resset/himudev_hw/README.md

# hIMUdev

hIMUdev is a RISC-V powered IMU evaluation board. Current version (1.0) hasn't been tested yet, so expect updates and changes.

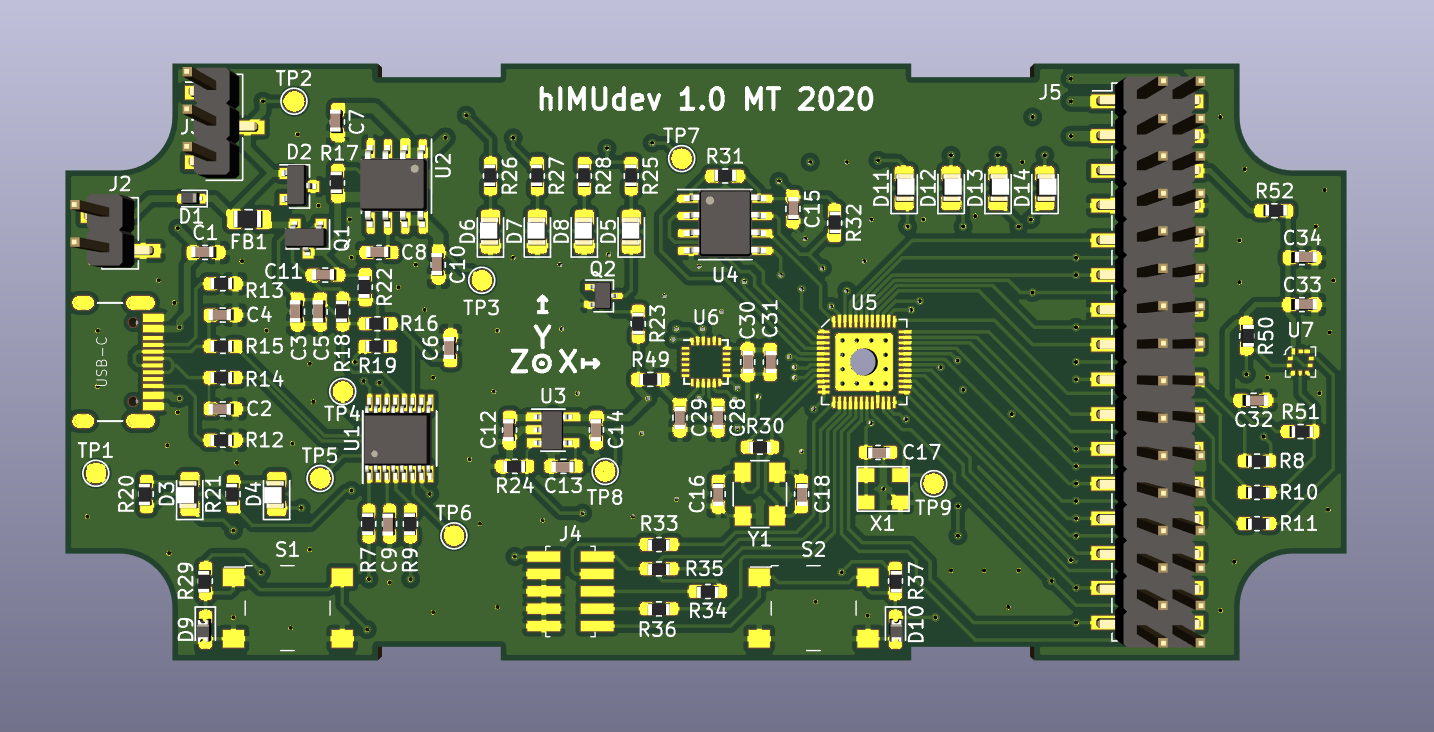
[picture p1: img/3d_viewer_board.png]
3D view

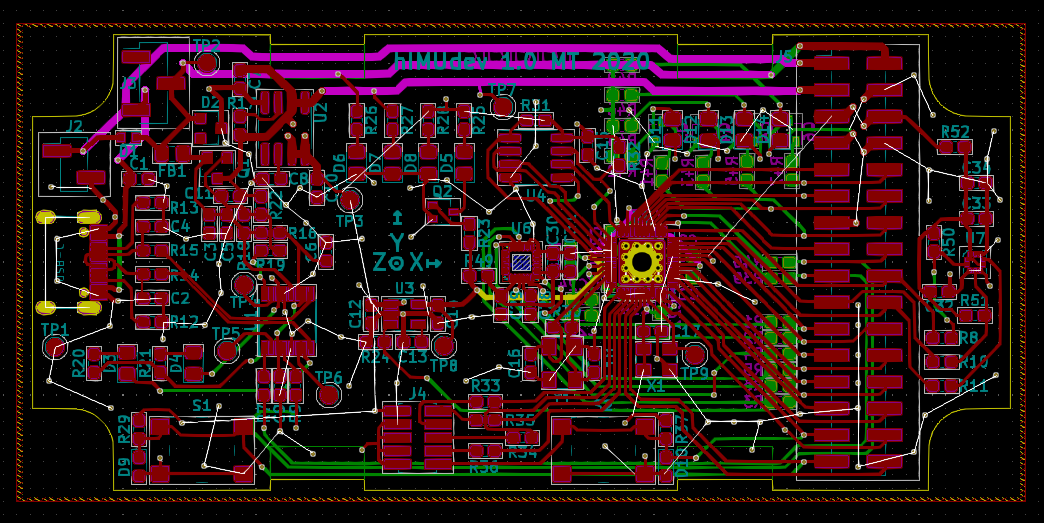
[picture p2: img/pcbnew_traces.png]
Layout view
