resset/himudev_hw/himudev.kicad_pcb

## KiCad design himudev.kicad_pcb (2020-05-10)

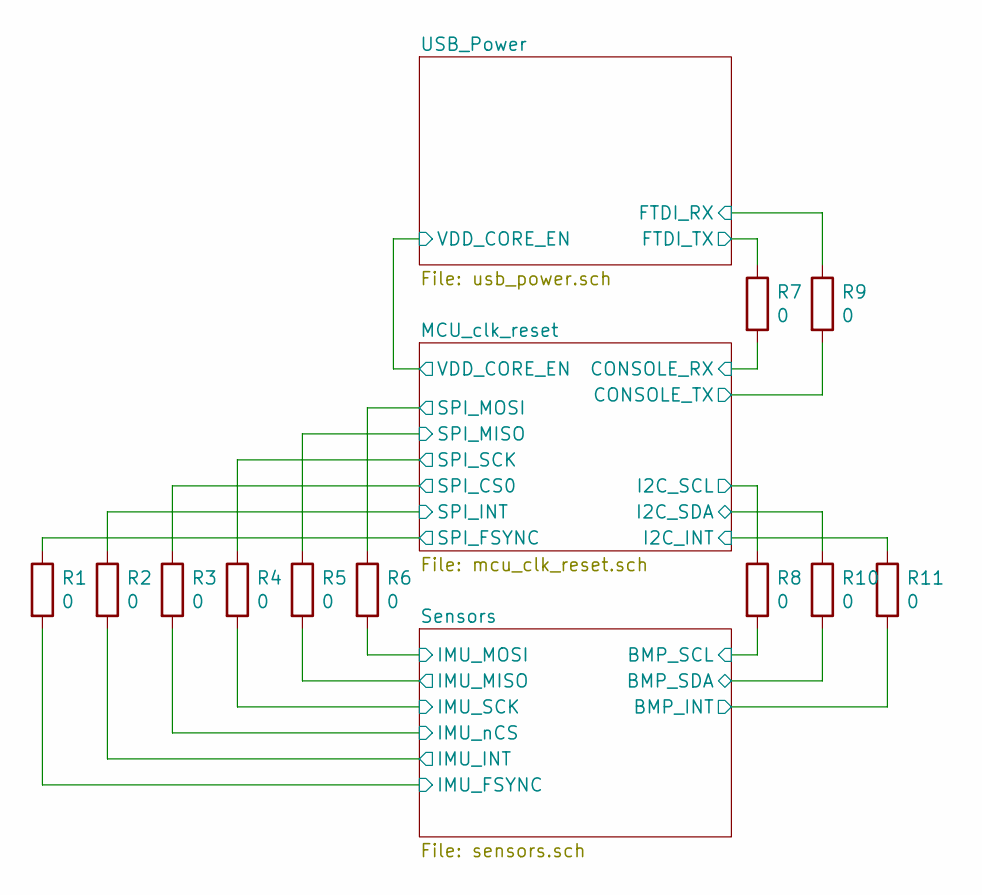
[picture p3: schematic himudev.sch]

Parts:
R1, R2, R3, R4, R5, R6, R7, R8, R9, R10, R11: 0; R_0603_1608Metric_Pad1.05x0.95mm_HandSolder

Connections:
/MCU_clk_reset/CONSOLE_RX: R7.2; also elsewhere on the board
/MCU_clk_reset/CONSOLE_TX: R9.2; also elsewhere on the board
/MCU_clk_reset/I2C_INT: R11.1; also elsewhere on the board
/MCU_clk_reset/I2C_SCL: R8.1; also elsewhere on the board
/MCU_clk_reset/I2C_SDA: R10.1; also elsewhere on the board
/MCU_clk_reset/SPI_CS0: R3.1; also elsewhere on the board
/MCU_clk_reset/SPI_FSYNC: R1.1; also elsewhere on the board
/MCU_clk_reset/SPI_INT: R2.1; also elsewhere on the board
/MCU_clk_reset/SPI_MISO: R5.1; also elsewhere on the board
/MCU_clk_reset/SPI_MOSI: R6.1; also elsewhere on the board
/MCU_clk_reset/SPI_SCK: R4.1; also elsewhere on the board
/Sensors/BMP_INT: R11.2; also elsewhere on the board
/Sensors/BMP_SCL: R8.2; also elsewhere on the board
/Sensors/BMP_SDA: R10.2; also elsewhere on the board
/Sensors/IMU_FSYNC: R1.2; also elsewhere on the board
/Sensors/IMU_INT: R2.2; also elsewhere on the board
/Sensors/IMU_MISO: R5.2; also elsewhere on the board
/Sensors/IMU_MOSI: R6.2; also elsewhere on the board
/Sensors/IMU_SCK: R4.2; also elsewhere on the board
/Sensors/IMU_nCS: R3.2; also elsewhere on the board
/USB_Power/FTDI_RX: R9.1; also elsewhere on the board
/USB_Power/FTDI_TX: R7.1; also elsewhere on the board

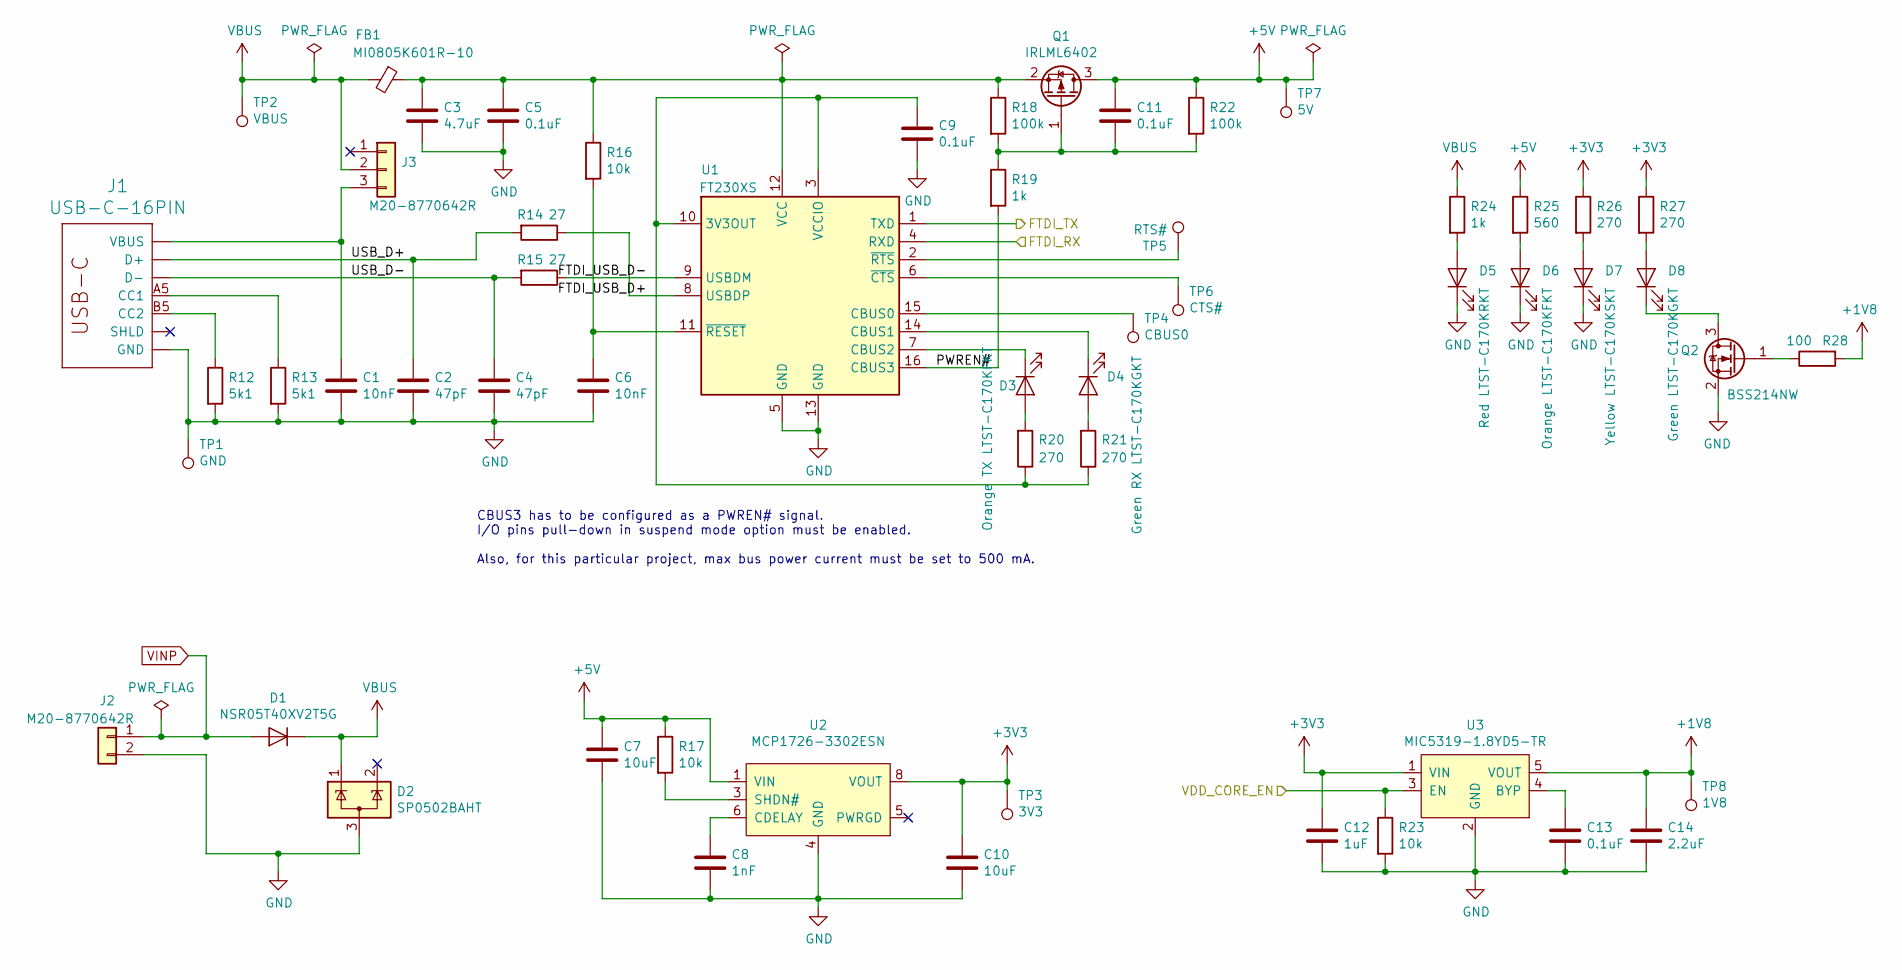
[picture p4: schematic usb_power.sch]

Parts:
C1, C6: 10nF; C_0603_1608Metric_Pad1.05x0.95mm_HandSolder
C2, C4: 47pF; C_0603_1608Metric_Pad1.05x0.95mm_HandSolder
C3: 4.7uF; C_0603_1608Metric_Pad1.05x0.95mm_HandSolder
C5, C9, C11, C13: 0.1uF; C_0603_1608Metric_Pad1.05x0.95mm_HandSolder
C7, C10: 10uF; C_0603_1608Metric_Pad1.05x0.95mm_HandSolder
C8: 1nF; C_0603_1608Metric_Pad1.05x0.95mm_HandSolder
C12: 1uF; C_0603_1608Metric_Pad1.05x0.95mm_HandSolder
C14: 2.2uF; C_0603_1608Metric_Pad1.05x0.95mm_HandSolder
D1: NSR05T40XV2T5G; D_SOD-523
D2: SP0502BAHT; SOT-23
D3: Orange TX LTST-C170KFKT; LED_0805_2012Metric_Pad1.15x1.40mm_HandSolder
D4: Green RX LTST-C170KGKT; LED_0805_2012Metric_Pad1.15x1.40mm_HandSolder
D5: Red LTST-C170KRKT; LED_0805_2012Metric_Pad1.15x1.40mm_HandSolder
D6: Orange LTST-C170KFKT; LED_0805_2012Metric_Pad1.15x1.40mm_HandSolder
D7: Yellow LTST-C170KSKT; LED_0805_2012Metric_Pad1.15x1.40mm_HandSolder
D8: Green LTST-C170KGKT; LED_0805_2012Metric_Pad1.15x1.40mm_HandSolder
FB1: MI0805K601R-10; R_0805_2012Metric_Pad1.15x1.40mm_HandSolder
J1: USB-C-16PIN; USB-C-COM-15111
J2: M20-8770642R; PinHeader_1x02_P2.54mm_Vertical_SMD_Pin1Left
J3: M20-8770642R; PinHeader_1x03_P2.54mm_Vertical_SMD_Pin1Left
Q1: IRLML6402; SOT-23
Q2: BSS214NW; SOT-323_SC-70
R12, R13: 5k1; R_0603_1608Metric_Pad1.05x0.95mm_HandSolder
R14, R15: 27; R_0603_1608Metric_Pad1.05x0.95mm_HandSolder
R16, R17, R23: 10k; R_0603_1608Metric_Pad1.05x0.95mm_HandSolder
R18, R22: 100k; R_0603_1608Metric_Pad1.05x0.95mm_HandSolder
R19, R24: 1k; R_0603_1608Metric_Pad1.05x0.95mm_HandSolder
R20, R21, R26, R27: 270; R_0603_1608Metric_Pad1.05x0.95mm_HandSolder
R25: 560; R_0603_1608Metric_Pad1.05x0.95mm_HandSolder
R28: 100; R_0603_1608Metric_Pad1.05x0.95mm_HandSolder
TP1: GND; TestPoint_Pad_D1.5mm
TP2: VBUS; TestPoint_Pad_D1.5mm
TP3: 3V3; TestPoint_Pad_D1.5mm
TP4: CBUS0; TestPoint_Pad_D1.5mm
TP5: RTS#; TestPoint_Pad_D1.5mm
TP6: CTS#; TestPoint_Pad_D1.5mm
TP7: 5V; TestPoint_Pad_D1.5mm
TP8: 1V8; TestPoint_Pad_D1.5mm
U1: FT230XS; SSOP-16_3.9x4.9mm_P0.635mm
U2: MCP1726-3302ESN; SOIC-8_3.9x4.9mm_P1.27mm
U3: MIC5319-1.8YD5-TR; TSOT-23-5

Connections:
+1V8: C14.1, R28.2, TP8.1, U3.5 (VOUT); also elsewhere on the board
+3V3: C10.1, C12.1, R26.1, R27.1, TP3.1, U2.7 (VOUT), U2.8 (VOUT), U3.1 (VIN); also elsewhere on the board
+5V: C7.1, C11.1, Q1.3 (D), R17.1, R22.1, R25.1, TP7.1, U2.1 (VIN), U2.2 (VIN); also elsewhere on the board
/MCU_clk_reset/VDD_CORE_EN: R23.1, U3.3 (EN); also elsewhere on the board
/USB_Power/FTDI_RX: U1.4 (RXD); also elsewhere on the board
/USB_Power/FTDI_TX: U1.1 (TXD); also elsewhere on the board
/USB_Power/FTDI_USB_D+: R14.1, U1.8 (USBDP)
/USB_Power/FTDI_USB_D-: R15.1, U1.9 (USBDM)
/USB_Power/PWREN#: R19.2, U1.16 (CBUS3)
/USB_Power/USB_D+: C2.1, J1.A6 (D+), J1.B6 (D+), R14.2
/USB_Power/USB_D-: C4.1, J1.A7 (D-), J1.B7 (D-), R15.2
GND: C1.2, C2.2, C3.2, C4.2, C5.2, C6.2, C7.2, C8.2, C9.2, C10.2, C12.2, C13.2, C14.2, D2.3 (A), D5.1 (K), D6.1 (K), D7.1 (K), J1.GND, J1.GND2 (GND), J2.2, Q2.2 (S), R12.2, R13.2, R23.2, TP1.1, U1.5 (GND), U1.13 (GND), U2.4 (GND), U3.2 (GND); also elsewhere on the board
unnamed: C1.1, J1.VBUS1 (VBUS), J1.VBUS2 (VBUS), J3.3
unnamed: C3.1, C5.1, FB1.1, Q1.2 (S), R16.1, R18.1, U1.12 (VCC)
unnamed: C6.1, R16.2, U1.11 (~RESET)
unnamed: C8.1, U2.6 (CDELAY)
unnamed: C9.1, R20.1, R21.1, U1.3 (VCCIO), U1.10 (3V3OUT)
unnamed: C11.2, Q1.1 (G), R18.2, R19.1, R22.2
unnamed: C13.1, U3.4 (BYP)
unnamed: D3.1 (K), U1.7 (CBUS2)
unnamed: D3.2 (A), R20.2
unnamed: D4.1 (K), U1.14 (CBUS1)
unnamed: D4.2 (A), R21.2
unnamed: D5.2 (A), R24.2
unnamed: D6.2 (A), R25.2
unnamed: D7.2 (A), R26.2
unnamed: D8.1 (K), Q2.3 (D)
unnamed: D8.2 (A), R27.2
unnamed: J1.A5 (CC1), R13.1
unnamed: J1.B5 (CC2), R12.1
unnamed: J1.SHLD1 (SHLD), J1.SHLD2 (SHLD), J1.SHLD3 (SHLD), J1.SHLD4 (SHLD), J1.SHLD5 (SHLD), J1.SHLD6 (SHLD), J1.SHLD7 (SHLD), J1.SHLD8 (SHLD)
unnamed: Q2.1 (G), R28.1
unnamed: R17.2, U2.3 (SHDN#)
unnamed: TP4.1, U1.15 (CBUS0)
unnamed: TP5.1, U1.2 (~RTS)
unnamed: TP6.1, U1.6 (~CTS)
VBUS: D1.1 (K), D2.1 (K), FB1.2, J3.2, R24.1, TP2.1; also elsewhere on the board
VINP: D1.2 (A), J2.1; also elsewhere on the board

Notes on the sheet:
CBUS3 has to be configured as a PWREN# signal. I/O pins pull-down in suspend mode option must be enabled. Also, for this particular project, max bus power current must be set to 500 mA.

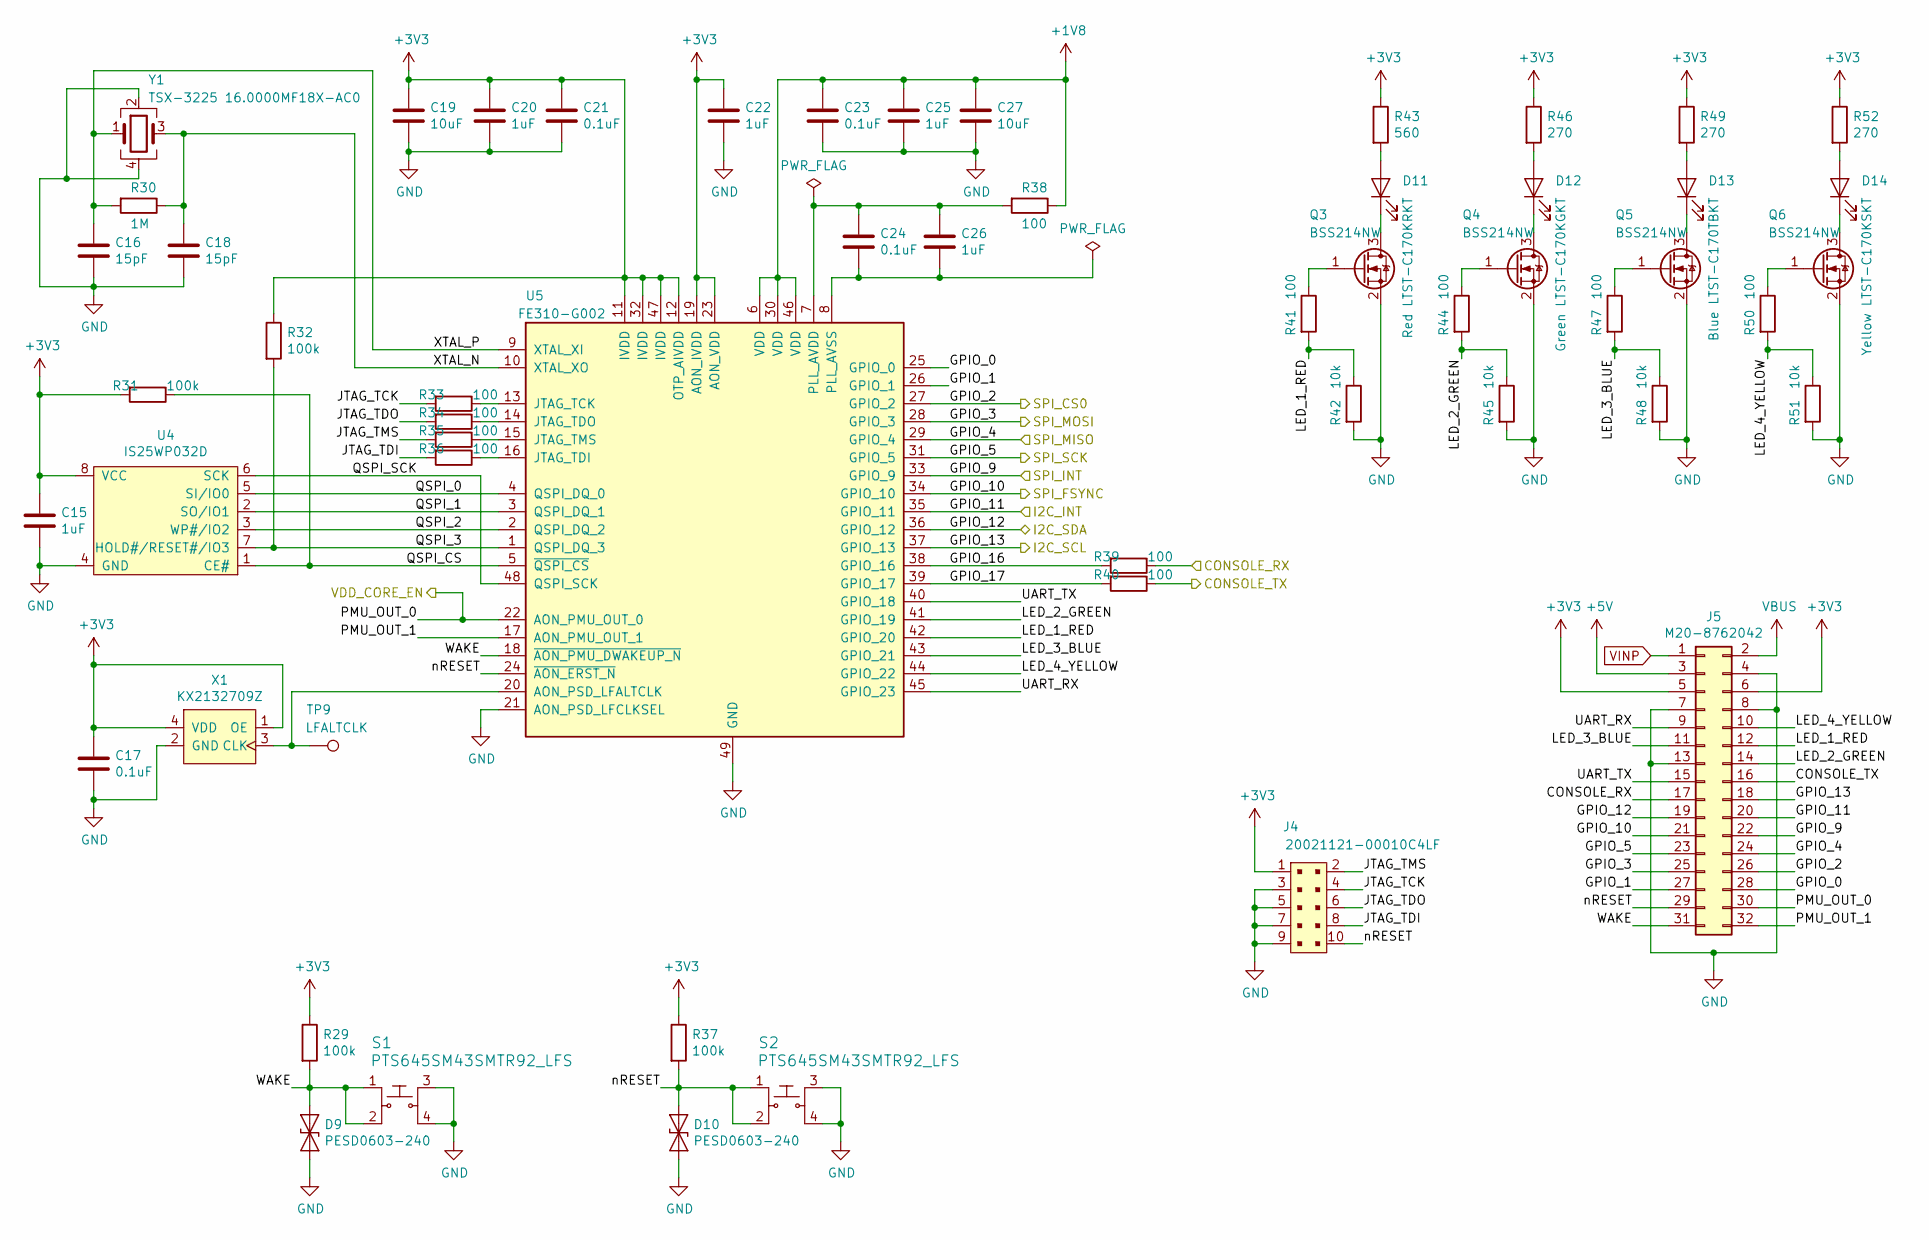
[picture p5: schematic mcu_clk_reset.sch]

Parts:
C15, C20, C22, C25, C26: 1uF; C_0603_1608Metric_Pad1.05x0.95mm_HandSolder
C16, C18: 15pF; C_0603_1608Metric_Pad1.05x0.95mm_HandSolder
C17, C21, C23, C24: 0.1uF; C_0603_1608Metric_Pad1.05x0.95mm_HandSolder
C19, C27: 10uF; C_0603_1608Metric_Pad1.05x0.95mm_HandSolder
D9, D10: PESD0603-240; D_0603_1608Metric_Pad1.05x0.95mm_HandSolder
D11: Red LTST-C170KRKT; LED_0805_2012Metric_Pad1.15x1.40mm_HandSolder
D12: Green LTST-C170KGKT; LED_0805_2012Metric_Pad1.15x1.40mm_HandSolder
D13: Blue LTST-C170TBKT; LED_0805_2012Metric_Pad1.15x1.40mm_HandSolder
D14: Yellow LTST-C170KSKT; LED_0805_2012Metric_Pad1.15x1.40mm_HandSolder
J4: 20021121-00010C4LF; PinHeader_2x5_P1.27mm; MPN 20021121-00010C4LF; Digi-Key_PN 609-3695-1-ND
J5: M20-8762042; PinHeader_2x16_P2.54mm_Vertical_SMD
Q3, Q4, Q5, Q6: BSS214NW; SOT-323_SC-70
R29, R31, R32, R37: 100k; R_0603_1608Metric_Pad1.05x0.95mm_HandSolder
R30: 1M; R_0603_1608Metric_Pad1.05x0.95mm_HandSolder
R33, R34, R35, R36, R38, R39, R40, R41, R44, R47, R50: 100; R_0603_1608Metric_Pad1.05x0.95mm_HandSolder
R42, R45, R48, R51: 10k; R_0603_1608Metric_Pad1.05x0.95mm_HandSolder
R43: 560; R_0603_1608Metric_Pad1.05x0.95mm_HandSolder
R46, R49, R52: 270; R_0603_1608Metric_Pad1.05x0.95mm_HandSolder
S1, S2: PTS645SM43SMTR92_LFS; Switch_Tactile_SMD_6x6mm_PTS645; MPN PTS645SM43SMTR92 LFS; Digi-Key_PN CKN9112CT-ND
TP9: LFALTCLK; TestPoint_Pad_D1.5mm
U4: IS25WP032D; SOIC-8_3.9x4.9mm_P1.27mm
U5: FE310-G002; QFN-48-1EP_6x6mm_P0.4mm_EP4.2x4.2mm_BigVia
X1: KX2132709Z
Y1: TSX-3225 16.0000MF18X-AC0; TSX-3225

Connections:
+1V8: C23.1, C25.1, C27.1, R38.1, U5.6 (VDD), U5.30 (VDD), U5.46 (VDD); also elsewhere on the board
+3V3: C15.1, C17.1, C19.1, C20.1, C21.1, C22.1, J4.1, J5.5, J5.6, R29.1, R31.2, R32.1, R37.1, R43.1, R46.1, R49.1, R52.1, U4.8 (VCC), U5.11 (IVDD), U5.12 (OTP_AIVDD), U5.19 (AON_IVDD), U5.23 (AON_VDD), U5.32 (IVDD), U5.47 (IVDD), X1.1 (OE), X1.4 (VDD); also elsewhere on the board
+5V: J5.3; also elsewhere on the board
/MCU_clk_reset/CONSOLE_RX: J5.17, R39.1; also elsewhere on the board
/MCU_clk_reset/CONSOLE_TX: J5.16, R40.1; also elsewhere on the board
/MCU_clk_reset/GPIO_0: J5.28, U5.25 (GPIO_0)
/MCU_clk_reset/GPIO_1: J5.27, U5.26 (GPIO_1)
/MCU_clk_reset/GPIO_16: R39.2, U5.38 (GPIO_16)
/MCU_clk_reset/GPIO_17: R40.2, U5.39 (GPIO_17)
/MCU_clk_reset/I2C_INT: J5.20, U5.35 (GPIO_11); also elsewhere on the board
/MCU_clk_reset/I2C_SCL: J5.18, U5.37 (GPIO_13); also elsewhere on the board
/MCU_clk_reset/I2C_SDA: J5.19, U5.36 (GPIO_12); also elsewhere on the board
/MCU_clk_reset/JTAG_TCK: J4.4, R33.2
/MCU_clk_reset/JTAG_TDI: J4.8, R36.2
/MCU_clk_reset/JTAG_TDO: J4.6, R34.2
/MCU_clk_reset/JTAG_TMS: J4.2, R35.2
/MCU_clk_reset/LED_1_RED: J5.12, R41.2, R42.1, U5.42 (GPIO_20)
/MCU_clk_reset/LED_2_GREEN: J5.14, R44.2, R45.1, U5.41 (GPIO_19)
/MCU_clk_reset/LED_3_BLUE: J5.11, R47.2, R48.1, U5.43 (GPIO_21)
/MCU_clk_reset/LED_4_YELLOW: J5.10, R50.2, R51.1, U5.44 (GPIO_22)
/MCU_clk_reset/PMU_OUT_1: J5.32, U5.17 (AON_PMU_OUT_1)
/MCU_clk_reset/QSPI_0: U4.5 (SI/IO0), U5.4 (QSPI_DQ_0)
/MCU_clk_reset/QSPI_1: U4.2 (SO/IO1), U5.3 (QSPI_DQ_1)
/MCU_clk_reset/QSPI_2: U4.3 (WP#/IO2), U5.2 (QSPI_DQ_2)
/MCU_clk_reset/QSPI_3: R32.2, U4.7 (HOLD#/RESET#/IO3), U5.1 (QSPI_DQ_3)
/MCU_clk_reset/QSPI_CS: R31.1, U4.1 (CE#), U5.5 (~QSPI_CS)
/MCU_clk_reset/QSPI_SCK: U4.6 (SCK), U5.48 (QSPI_SCK)
/MCU_clk_reset/SPI_CS0: J5.26, U5.27 (GPIO_2); also elsewhere on the board
/MCU_clk_reset/SPI_FSYNC: J5.21, U5.34 (GPIO_10); also elsewhere on the board
/MCU_clk_reset/SPI_INT: J5.22, U5.33 (GPIO_9); also elsewhere on the board
/MCU_clk_reset/SPI_MISO: J5.24, U5.29 (GPIO_4); also elsewhere on the board
/MCU_clk_reset/SPI_MOSI: J5.25, U5.28 (GPIO_3); also elsewhere on the board
/MCU_clk_reset/SPI_SCK: J5.23, U5.31 (GPIO_5); also elsewhere on the board
/MCU_clk_reset/UART_RX: J5.9, U5.45 (GPIO_23)
/MCU_clk_reset/UART_TX: J5.15, U5.40 (GPIO_18)
/MCU_clk_reset/VDD_CORE_EN: J5.30, U5.22 (AON_PMU_OUT_0); also elsewhere on the board
/MCU_clk_reset/WAKE: D9.1 (A1), J5.31, R29.2, S1.1, S1.2, U5.18 (~AON_PMU_DWAKEUP_N)
/MCU_clk_reset/XTAL_N: C18.1, R30.1, U5.10 (XTAL_XO), Y1.3
/MCU_clk_reset/XTAL_P: C16.1, R30.2, U5.9 (XTAL_XI), Y1.1
/MCU_clk_reset/nRESET: D10.1 (A1), J4.10, J5.29, R37.2, S2.1, S2.2, U5.24 (~AON_ERST_N)
GND: C15.2, C16.2, C17.2, C18.2, C19.2, C20.2, C21.2, C22.2, C23.2, C25.2, C27.2, D9.2 (A2), D10.2 (A2), J4.3, J4.5, J4.7, J4.9, J5.4, J5.7, J5.8, J5.13, Q3.2 (S), Q4.2 (S), Q5.2 (S), Q6.2 (S), R42.2, R45.2, R48.2, R51.2, S1.3, S1.4, S2.3, S2.4, U4.4 (GND), U5.21 (AON_PSD_LFCLKSEL), U5.49 (GND), X1.2 (GND), Y1.2, Y1.4; also elsewhere on the board
unnamed: C24.1, C26.1, R38.2, U5.7 (PLL_AVDD)
unnamed: C24.2, C26.2, U5.8 (PLL_AVSS)
unnamed: D11.1 (K), Q3.3 (D)
unnamed: D11.2 (A), R43.2
unnamed: D12.1 (K), Q4.3 (D)
unnamed: D12.2 (A), R46.2
unnamed: D13.1 (K), Q5.3 (D)
unnamed: D13.2 (A), R49.2
unnamed: D14.1 (K), Q6.3 (D)
unnamed: D14.2 (A), R52.2
unnamed: Q3.1 (G), R41.1
unnamed: Q4.1 (G), R44.1
unnamed: Q5.1 (G), R47.1
unnamed: Q6.1 (G), R50.1
unnamed: R33.1, U5.13 (JTAG_TCK)
unnamed: R34.1, U5.14 (JTAG_TDO)
unnamed: R35.1, U5.15 (JTAG_TMS)
unnamed: R36.1, U5.16 (JTAG_TDI)
unnamed: TP9.1, U5.20 (AON_PSD_LFALTCLK), X1.3 (CLK)
VBUS: J5.2; also elsewhere on the board
VINP: J5.1; also elsewhere on the board

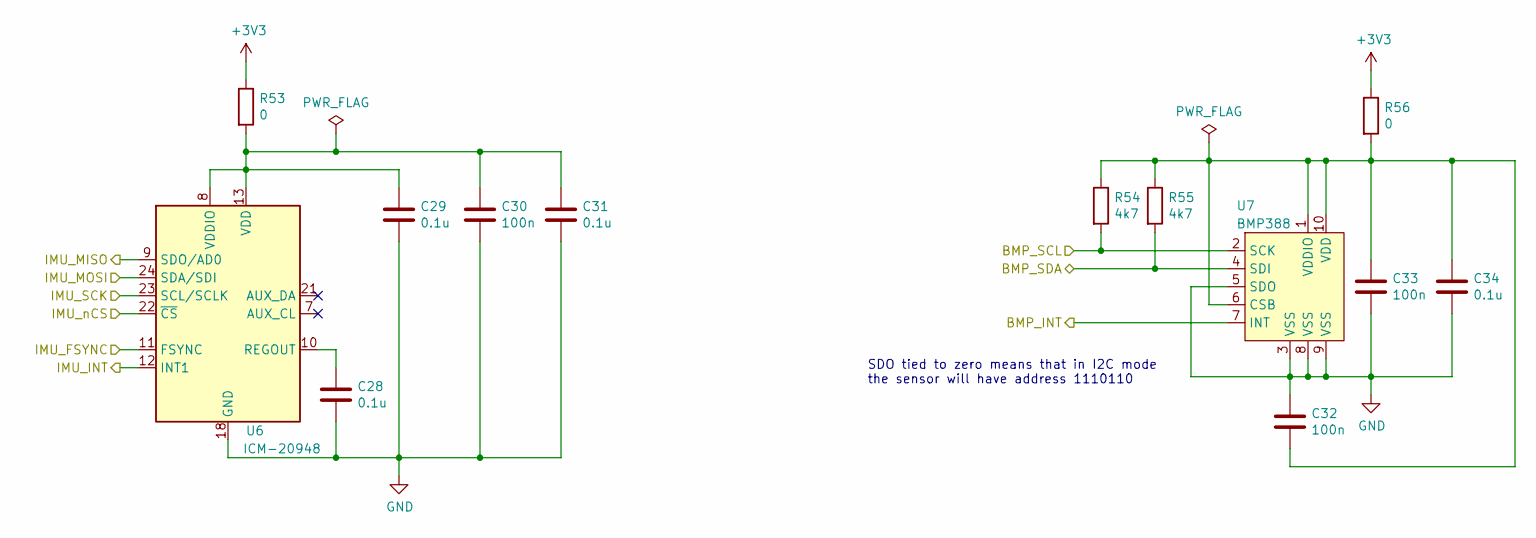
[picture p6: schematic sensors.sch]

Parts:
C28, C29, C31, C34: 0.1u; C_0603_1608Metric_Pad1.05x0.95mm_HandSolder
C30, C32, C33: 100n; C_0603_1608Metric_Pad1.05x0.95mm_HandSolder
R53, R56: 0; R_0603_1608Metric_Pad1.05x0.95mm_HandSolder
R54, R55: 4k7; R_0603_1608Metric_Pad1.05x0.95mm_HandSolder
U6: ICM-20948; InvenSense_QFN-24_3x3mm_P0.4mm
U7: BMP388; Bosch_LGA-10_2x2mm_P0.5mm

Connections:
+3V3: R53.1, R56.1; also elsewhere on the board
/Sensors/BMP_INT: U7.7 (INT); also elsewhere on the board
/Sensors/BMP_SCL: R54.2, U7.2 (SCK); also elsewhere on the board
/Sensors/BMP_SDA: R55.2, U7.4 (SDI); also elsewhere on the board
/Sensors/IMU_FSYNC: U6.11 (FSYNC); also elsewhere on the board
/Sensors/IMU_INT: U6.12 (INT1); also elsewhere on the board
/Sensors/IMU_MISO: U6.9 (SDO/AD0); also elsewhere on the board
/Sensors/IMU_MOSI: U6.24 (SDA/SDI); also elsewhere on the board
/Sensors/IMU_SCK: U6.23 (SCL/SCLK); also elsewhere on the board
/Sensors/IMU_nCS: U6.22 (~CS); also elsewhere on the board
GND: C28.2, C29.2, C30.2, C31.2, C32.1, C33.2, C34.2, U6.18 (GND), U6.20 (GND), U7.3 (VSS), U7.5 (SDO), U7.8 (VSS), U7.9 (VSS); also elsewhere on the board
unnamed: C28.1, U6.10 (REGOUT)
unnamed: C29.1, C30.1, C31.1, R53.2, U6.8 (VDDIO), U6.13 (VDD)
unnamed: C32.2, C33.1, C34.1, R54.1, R55.1, R56.2, U7.1 (VDDIO), U7.6 (CSB), U7.10 (VDD)

Notes on the sheet:
SDO tied to zero means that in I2C mode the sensor will have address 1110110

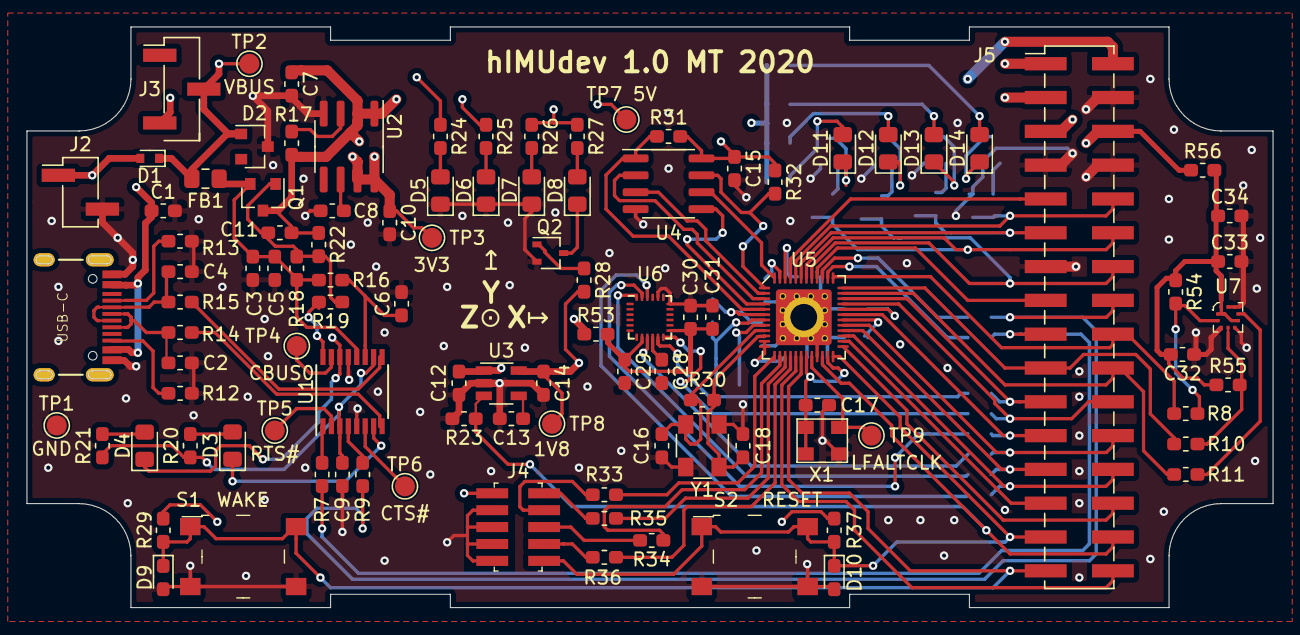
[picture p7: board himudev.kicad_pcb from above]

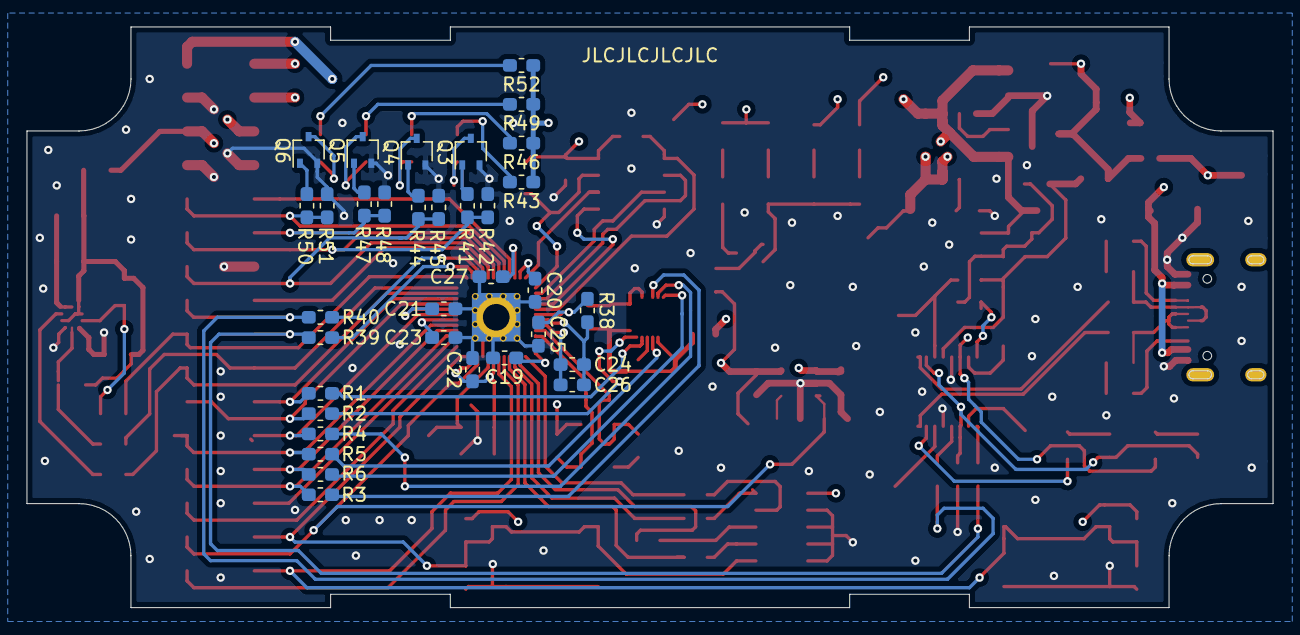
[picture p8: board himudev.kicad_pcb from below]

Board: 4 copper layers, 93.6 x 43.6 mm, 136 parts (34 on the bottom side), 105 nets.
