resset/himudev_hw/(commit log)

2019-12-22 Initial commit
    Power & clock section mostly done, MCU present.
    [himudev.kicad_pcb, himudev.sch, mcu_clk_reset.sch, sensors.sch, usb_power.sch]
2019-12-22 Update LEDs descriptions, add main osc footprint
    [mcu_clk_reset.sch, usb_power.sch]
2019-12-22 Change main MCU footprint
    Now it has a big hole in the back which will help me connecting it to GND
    with a soldering iron.
    [mcu_clk_reset.sch]
2019-12-22 Select footprint for main osc
    [mcu_clk_reset.sch]
2019-12-22 Add QSPI flash
    [mcu_clk_reset.sch]
2020-01-13 First full version of a schematic
    This commit is a quicksave of completed but not reviewed schematic.
    Added pressure sensor, finished IMU wiring, finished top-level
    schematic, added pin header, placed LEDs and many others.
    [himudev.sch, mcu_clk_reset.sch, sensors.sch, usb_power.sch]
2020-01-13 Moved some schematics around, no real changes
    [mcu_clk_reset.sch, usb_power.sch]
2020-01-13 Add ERC fixes, mostly PWR_FLAGs
    Also, fixed MCP1726 symbol.
    [himudev.sch, mcu_clk_reset.sch, sensors.sch, usb_power.sch]
2020-01-13 Assigned footprints, generated netlist
    I can already see some footprints issues. Eg. the switches have to be
    changed to the SMT version. There are some silkscreen issues in custom
    oscillator footprints. Otherwise looks promising :)
    [himudev.kicad_pcb, himudev.sch, mcu_clk_reset.sch, sensors.sch, usb_power.sch]
2020-01-13 Change board to four-layer one
    [himudev.kicad_pcb]
2020-01-14 Fix silkscreen on himudev footprints
    [himudev.kicad_pcb]
2020-01-14 Change tactile switches to PTS645
    [mcu_clk_reset.sch]
2020-01-14 Reload netlist, set part number of J1 and J3
    [himudev.kicad_pcb, mcu_clk_reset.sch, usb_power.sch]
2020-01-15 Placed component footprints in logical groups
    [himudev.kicad_pcb]
2020-01-16 Changed main header from 34 to 32 pin, added board outline
    [himudev.kicad_pcb, mcu_clk_reset.sch]
2020-02-01 Placed pressure sensor, connector changed to USB-C
    [himudev.kicad_pcb, sensors.sch, usb_power.sch]
2020-02-01 Route power traces on the inner layer
    [himudev.kicad_pcb, mcu_clk_reset.sch, usb_power.sch]
2020-02-02 Add board cutouts (enclosure features)
    Also, more placement of the components done.
    [himudev.kicad_pcb]
2020-02-05 Remap main header pins
    Allows for better use of board estate.
    [himudev.kicad_pcb, mcu_clk_reset.sch]
2020-02-08 Re-annotated all elements
    This is a step to prepare for a change from 0805 to 0603 components. Not
    critical but nice to have them in order.
    [mcu_clk_reset.sch, sensors.sch, usb_power.sch]
2020-03-05 Use 0603 components, on both sides, route header
    This decision was due to the current placement overcrowded and to the
    fact that successful routing on one side was uncertain.
    [himudev.kicad_pcb, himudev.sch, mcu_clk_reset.sch, sensors.sch, usb_power.sch]
2020-03-06 Placed MCU decoupling capacitors
    [himudev.kicad_pcb, mcu_clk_reset.sch]
2020-03-06 Placed everything apart from FTDI
    [himudev.kicad_pcb, sensors.sch]
2020-03-06 FTDI placement proposal, not connected yet
    [himudev.kicad_pcb, sensors.sch, usb_power.sch]
2020-03-06 Finished routing
    Yay!
    [himudev.kicad_pcb]
2020-03-06 Small via & silkscreen fixes
    [himudev.kicad_pcb]
2020-03-06 Add JLCPCB SN placeholder, fix silkscreen
    [himudev.kicad_pcb]
2020-03-06 Export Gerber and drill files
    [himudev-B_Cu.gbr, himudev-B_Mask.gbr, himudev-B_SilkS.gbr, himudev-Edge_Cuts.gbr, himudev-F_Cu.gbr, himudev-F_Mask.gbr, himudev-F_SilkS.gbr, himudev-In1_Cu.gbr]
2020-03-07 Made testpoint silkscreen more readable
    Also, regenerated Gerber files.
    [himudev-B_Cu.gbr, himudev-B_Mask.gbr, himudev-B_SilkS.gbr, himudev-Edge_Cuts.gbr, himudev-F_Cu.gbr, himudev-F_Mask.gbr, himudev-F_SilkS.gbr, himudev-In1_Cu.gbr]
2020-04-06 Fix labels placement on the schematics
    [mcu_clk_reset.sch, usb_power.sch]
2020-04-06 .gitignore: do not track KiBoM ini file
2020-04-06 Added TODO with a list of changes. Not final.
    The good news is that 75% of the board works, the rest is not tested
    yet. Things to check:
    - IMU
    - BMP
2020-04-06 Reorder power LEDs in schematics, fix some USB-C DRC errors
    [himudev.kicad_pcb, usb_power.sch]
2020-04-06 Fix: exchange FTDI TX and RX diode colors
    [himudev.kicad_pcb, usb_power.sch]
2020-04-08 Fix FTDI RX/TX diode designator
    [himudev.kicad_pcb, usb_power.sch]
2020-04-11 Change resistor values to adjust LED brightness
    [himudev.kicad_pcb, mcu_clk_reset.sch, usb_power.sch]
2020-04-13 Add 10k pull-downs on MCU LED outputs, improve layout
    Pushed few traces, fixed DRC issue on one of the vias.
    [himudev.kicad_pcb, mcu_clk_reset.sch, sensors.sch, usb_power.sch]
2020-04-13 Switch places of D3 and D4
    Also, fixed 1V8 via placement.
    [himudev.kicad_pcb]
2020-04-13 Move J4 up by 1 mm, add copper keepout around GND pins
    [himudev.kicad_pcb]
2020-04-16 Tidy up schematics a bit
    [mcu_clk_reset.sch]
2020-04-16 Rejest Y1 rotation, add trace length TODO
2020-04-21 Add magnificent InteractiveHtmlBom BOM
2020-04-28 Add nets and tracks to the HTML BOM
2020-05-09 Add testpoints labels
    [himudev.kicad_pcb]
2020-05-09 Add labels for buttons
    [himudev.kicad_pcb, mcu_clk_reset.sch, usb_power.sch]
2020-05-10 Change ICM-20948 supply from 1V8 to 3V3
    [himudev.kicad_pcb, sensors.sch]
2020-05-10 Update HTML BOM
2020-05-11 TODO: add IMU voltage level translators task
    This is something I overlooked and a bug in a schematics. GPIOs of the
    IMU work in 1V8 domain only so some kind of level translation is needed.
    And it should land close to the IMU itself, so the J5 stays in the 3V3
    domain.
